BEMNETADEFIS/Robo-Sheild-For-Arduino-ROB-11002/Others/Arduino_Robo_Shield_BOM.xlsx

Id | Designator | Package | Quantity | Designation | Supplier and ref | Price
1 | SW1 | switch-misc-9077-2 | 1 | SPST
2 | U1 | SparkFun-AUDIO-JACK | 1 | 3.5MM_JACK
3 | P12,P8 | SIL-8 | 2 | CONN_8
4 | P9 | SIL-6 | 1 | CONN_6
5 | Sensors1 | SIL-5 | 1 | CONN_5
6 | P13 | SIL-4 | 1 | BT/ZIGBEE
7 | P10 | SIL-4 | 1 | CONN_4
8 | P1 | SIL-2 | 1 | AUDIO_IN
9 | P11 | SIL-10 | 1 | CONN_10
10 | R11,R10,R12 | R4 | 3 | 470r
11 | R9 | R4 | 1 | 150k
12 | R1,R4,R3,R2 | R4 | 4 | 56K
13 | R7 | R4 | 1 | 68K
14 | R6 | R4 | 1 | 47K
15 | R5 | R4 | 1 | 330K
16 | R8 | R4 | 1 | 100K
17 | D10,D9,D7,D5,D14,D6,D11,D13,D12,D8 | LED-3MM | 10 | LED
18 | X1 | HC-49V | 1 | 3.5795MHz
19 | IC1 | DIP-18__300_ELL | 1 | MT8870P
20 | U3 | DIP-16__300_ELL | 1 | L293D_XL
21 | D2,D1 | D3 | 2 | 5.6V
22 | D4 | D3 | 1 | 1N14148
23 | C2,C1 | C1V5 | 2 | 10uF, 25V
24 | P14 | bornier2 | 1 | Motar1
25 | P15 | bornier2 | 1 | motar2
26 | P3 | bornier2 | 1 | MTR_PWR
27 | P7,P5 | 1pin | 2 | CONN_1
28 | SW2 | SparkFun-DIPSWITCH-02 | 1 | DPST
29 | R13,R14 | R4 | 2 | R
30 | P2 | bornier2 | 1 | BRD_PWR
