BEMNETADEFIS/Robo-Sheild-For-Arduino-ROB-11002/Hardware/Arduino_Robo_Shield.pdf

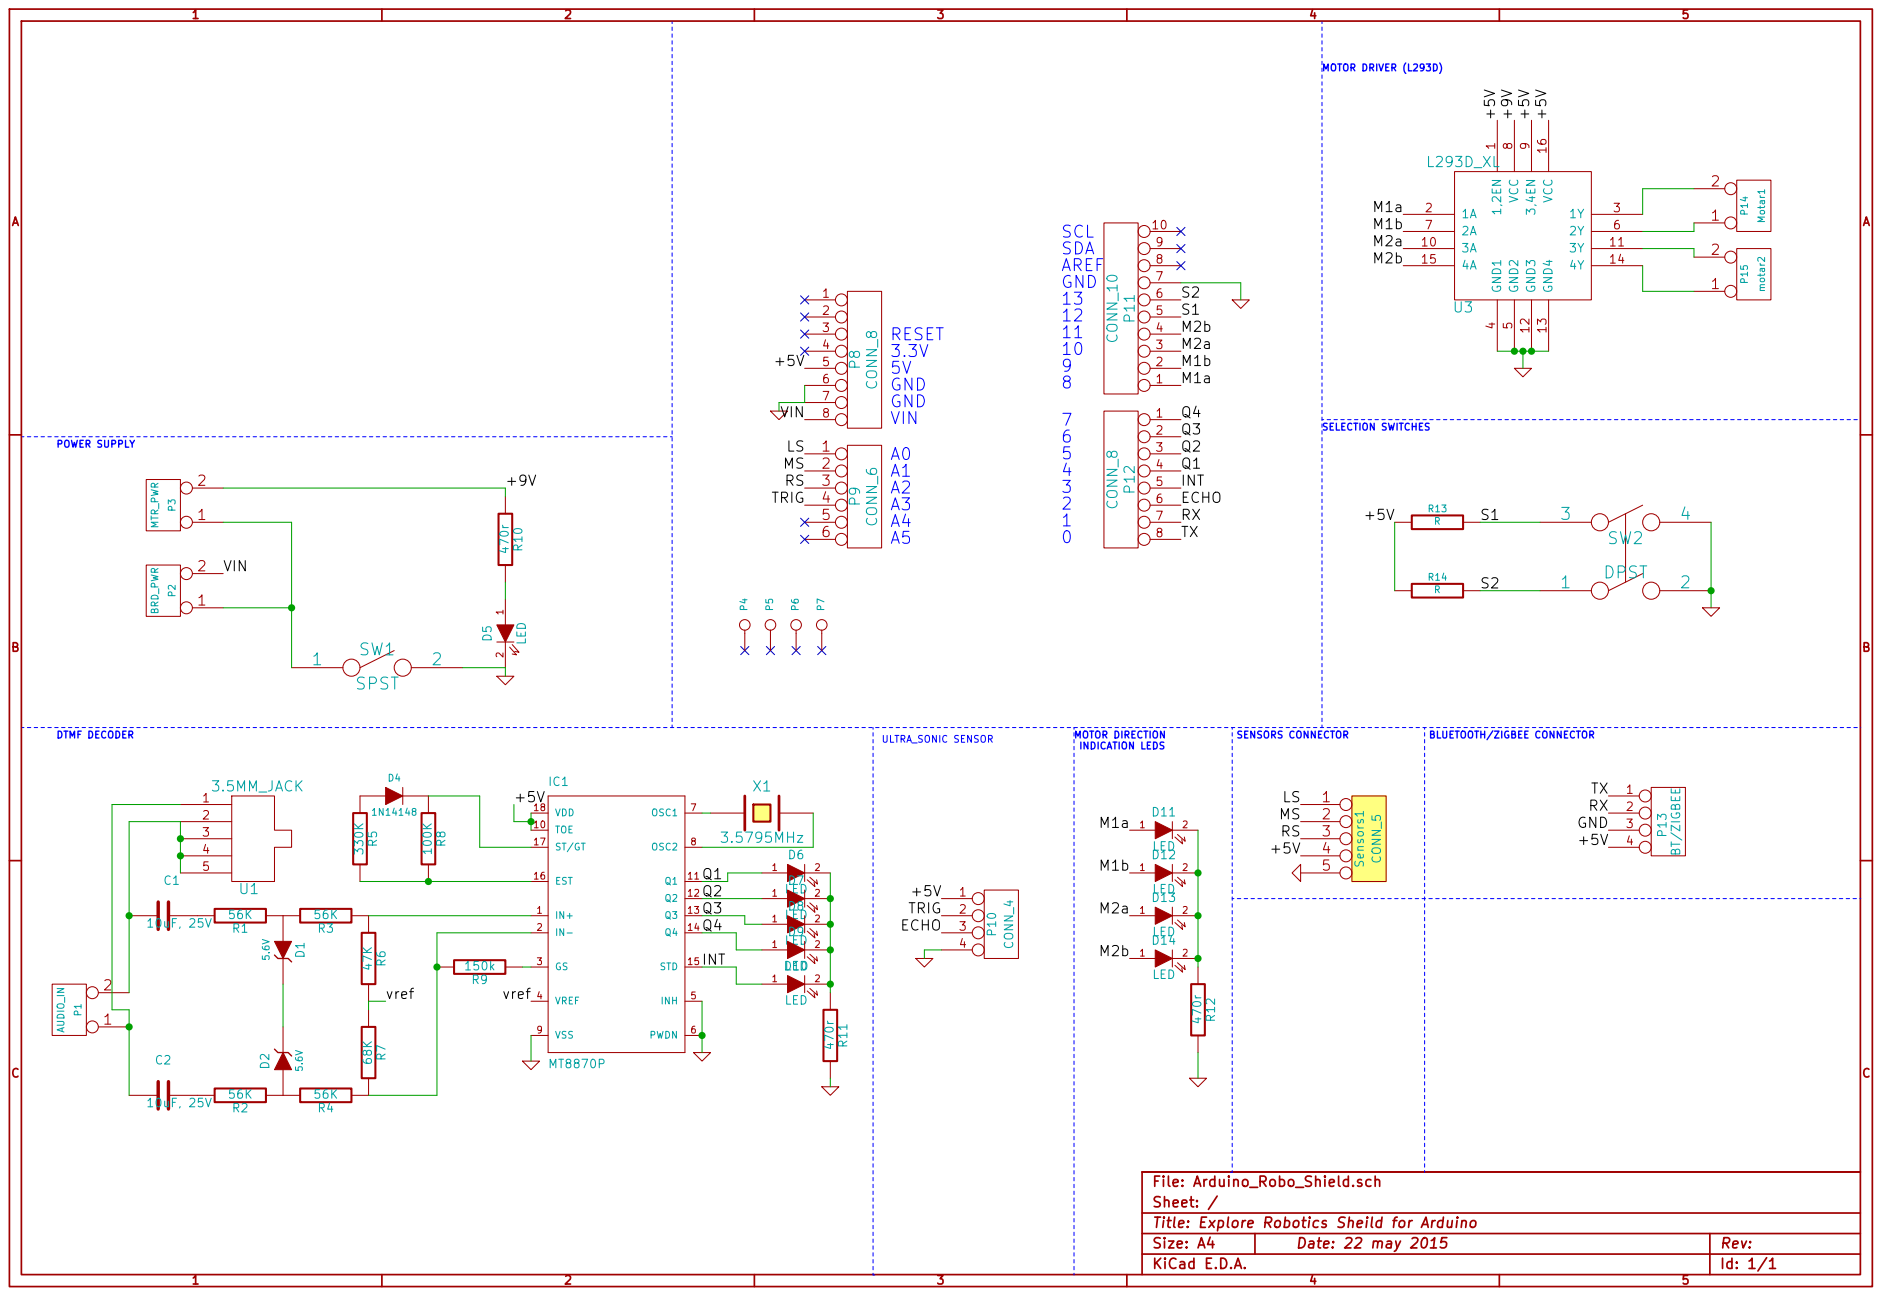
[picture p1: page 1]

Title: Explore Robotics Sheild for Arduino
KiCad E.D.A.
