BEMNETADEFIS/Robo-Sheild-For-Arduino-ROB-11002/Hardware/Arduino_Robo_Shield.kicad_pcb

## KiCad design Hardware/Arduino_Robo_Shield.kicad_pcb (2015-05-21)

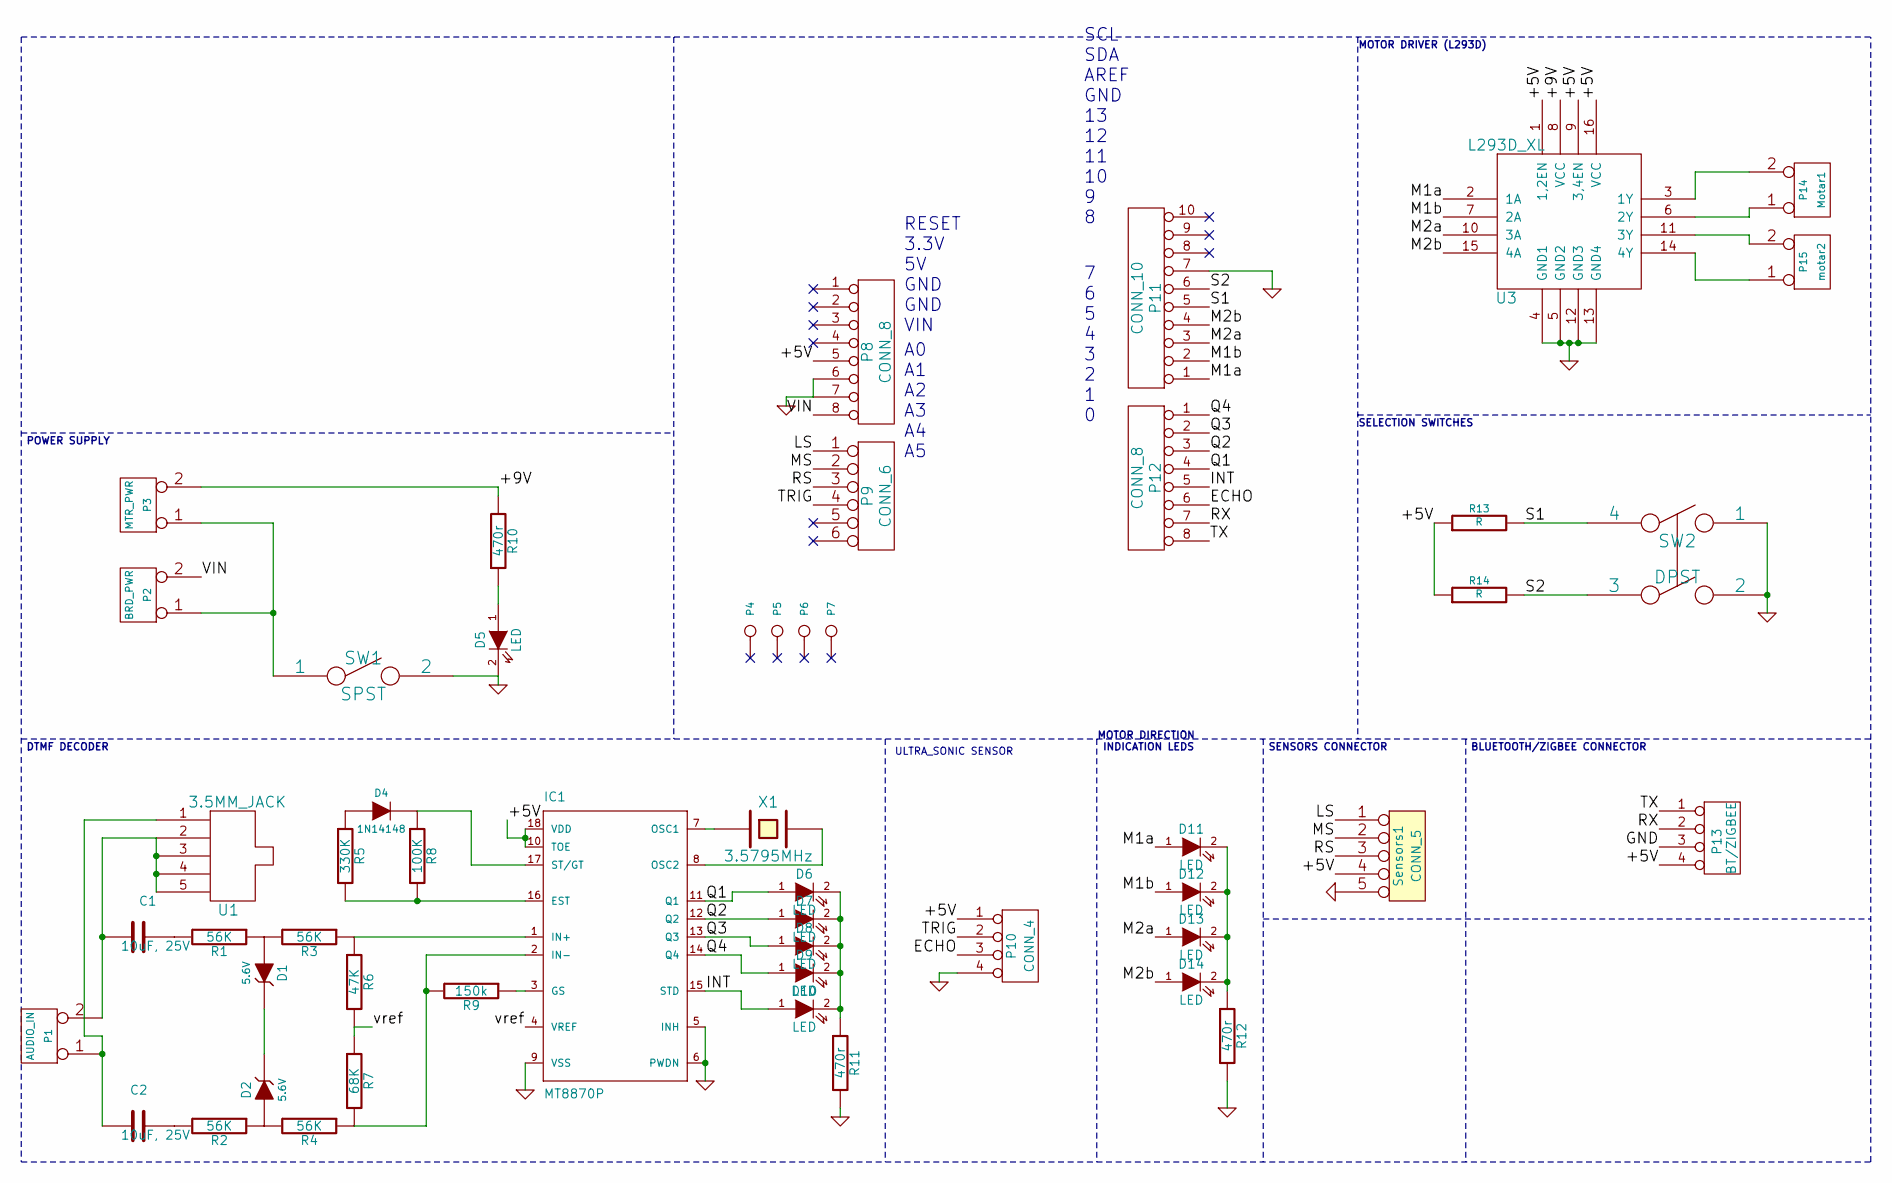
[picture p2: schematic Arduino_Robo_Shield.sch]

Parts:
C1, C2: 10uF, 25V
D1, D2: 5.6V
D4: 1N14148
D5, D6, D7, D8, D9, D10, D11, D12, D13, D14: LED
IC1: MT8870P; mitel-DIL18
P1: AUDIO_IN
P2: BRD_PWR
P3: MTR_PWR
P4, P5, P6, P7: CONN_1
P8, P12: CONN_8
P9: CONN_6
P10: CONN_4
P11: CONN_10
P13: BT/ZIGBEE
P14: Motar1
P15: motar2
R1, R2, R3, R4: 56K
R5: 330K
R6: 47K
R7: 68K
R8: 100K
R9: 150k
R10, R11, R12: 470r
R13, R14: R
SW1: SPST
SW2: DPST
Sensors1: CONN_5
U1: 3.5MM_JACK
U3: L293D_XL
X1: 3.5795MHz

Connections:
/+5V: IC1.10 (TOE), IC1.18 (VDD), P8.5, P10.1, P13.4, R13.1, R14.1, Sensors1.4, U3.1 (1,2EN), U3.9 (3,4EN), U3.16 (VCC)
/+9V: P3.2 (PM), R10.2, U3.8 (VCC)
/ECHO: P10.3, P12.6
/INT: D10.1 (A), IC1.15 (STD), P12.5
/LS: P9.1, Sensors1.1
/M1a: D11.1 (A), P11.1, U3.2 (1A)
/M1b: D12.1 (A), P11.2, U3.7 (2A)
/M2a: D13.1 (A), P11.3, U3.10 (3A)
/M2b: D14.1 (A), P11.4, U3.15 (4A)
/MS: P9.2, Sensors1.2
/Q1: D6.1 (A), IC1.11 (Q1), P12.4
/Q2: D7.1 (A), IC1.12 (Q2), P12.3
/Q3: D8.1 (A), IC1.13 (Q3), P12.2
/Q4: D9.1 (A), IC1.14 (Q4), P12.1
/RS: P9.3, Sensors1.3
/RX: P12.7, P13.2
/S1: P11.5, R13.2, SW2.4
/S2: P11.6, R14.2, SW2.3
/TRIG: P9.4, P10.2
/TX: P12.8, P13.1
/VIN: P2.2 (PM), P8.8
/vref: IC1.4 (VREF), R6.2, R7.1
GND: D5.2 (K), IC1.5 (INH), IC1.6 (PWDN), IC1.9 (VSS), P8.6, P8.7, P10.4, P11.7, P13.3, R11.2, R12.2, SW1.2, SW2.1, SW2.2, Sensors1.5, U3.4 (GND1), U3.5 (GND2), U3.12 (GND3), U3.13 (GND4)
unnamed: IC1.3 (GS), R9.1
unnamed: D1.2 (K), D2.2 (K)
unnamed: IC1.1 (IN+), R3.1, R6.1
unnamed: D4.2 (K), IC1.17 (ST/GT), R8.1
unnamed: IC1.7 (OSC1), X1.1
unnamed: IC1.8 (OSC2), X1.2
unnamed: P2.1, P3.1, SW1.1
unnamed: D5.1 (A), R10.1
unnamed: P15.1, U3.14 (4Y)
unnamed: P14.2 (PM), U3.3 (1Y)
unnamed: P15.2 (PM), U3.11 (3Y)
unnamed: P14.1, U3.6 (2Y)
unnamed: D2.1 (A), R2.1, R4.2
unnamed: D1.1 (A), R1.1, R3.2
unnamed: C2.2, P1.1, U1.1
unnamed: C2.1, R2.2
unnamed: C1.2, P1.2 (PM), U1.2, U1.3, U1.4, U1.5
unnamed: C1.1, R1.2
unnamed: D4.1 (A), R5.1
unnamed: IC1.16 (EST), R5.2, R8.2
unnamed: D6.2 (K), D7.2 (K), D8.2 (K), D9.2 (K), D10.2 (K), R11.1
unnamed: IC1.2 (IN-), R4.1, R7.2, R9.2
unnamed: D11.2 (K), D12.2 (K), D13.2 (K), D14.2 (K), R12.1

Notes on the sheet:
MOTOR DRIVER (L293D)
POWER SUPPLY
DTMF DECODER
MOTOR DIRECTION INDICATION LEDS
SENSORS CONNECTOR
BLUETOOTH/ZIGBEE CONNECTOR
SELECTION SWITCHES
7 6 5 4 3 2 1 0
SCL SDA AREF GND 13 12 11 10 9 8
A0 A1 A2 A3 A4 A5
RESET 3.3V 5V GND GND VIN
ULTRA_SONIC SENSOR

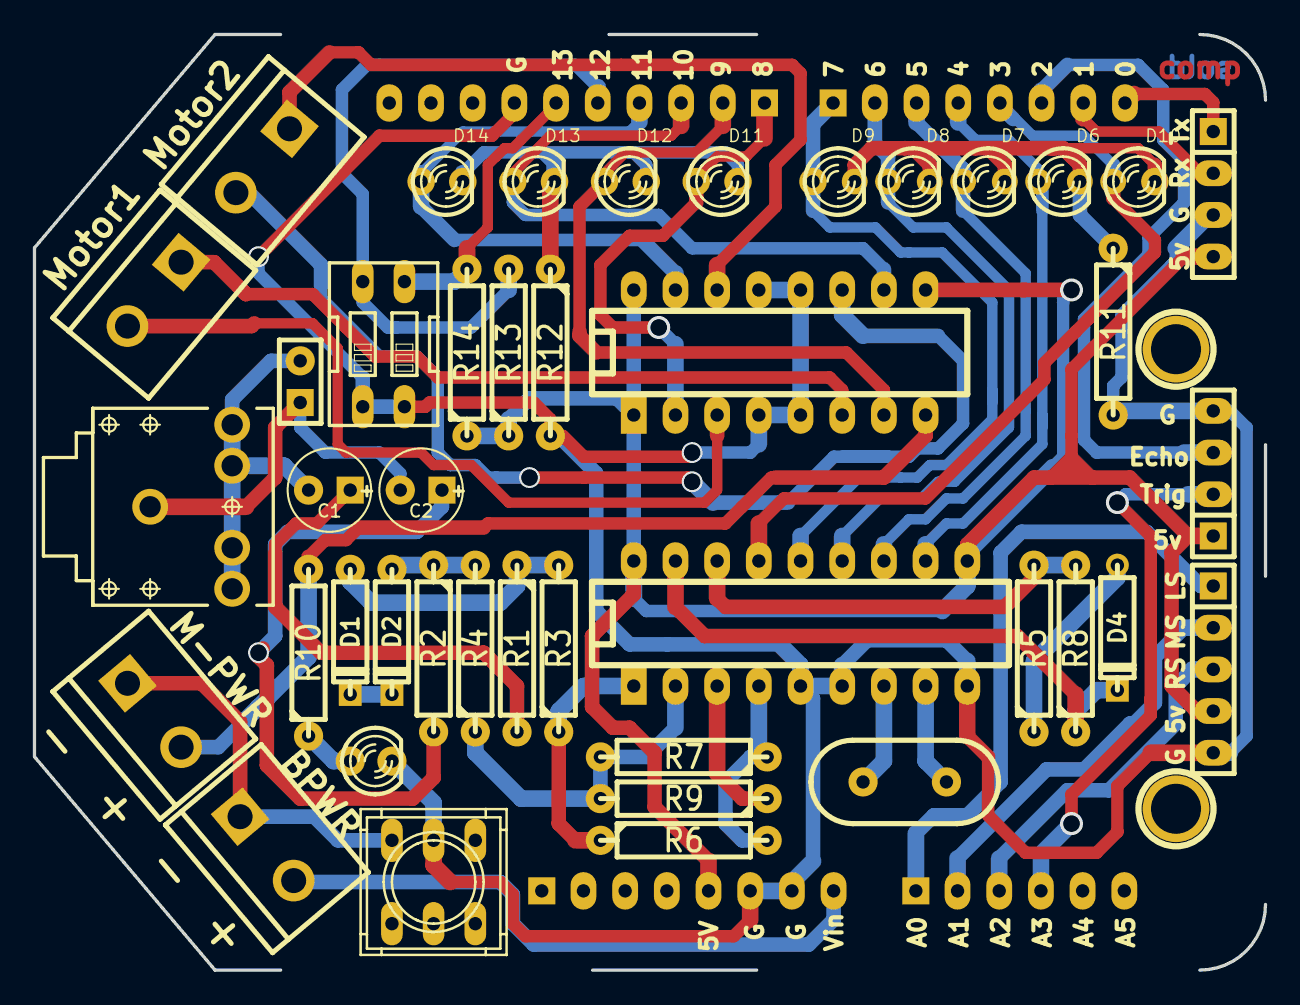
[picture p3: board Arduino_Robo_Shield.kicad_pcb from above]

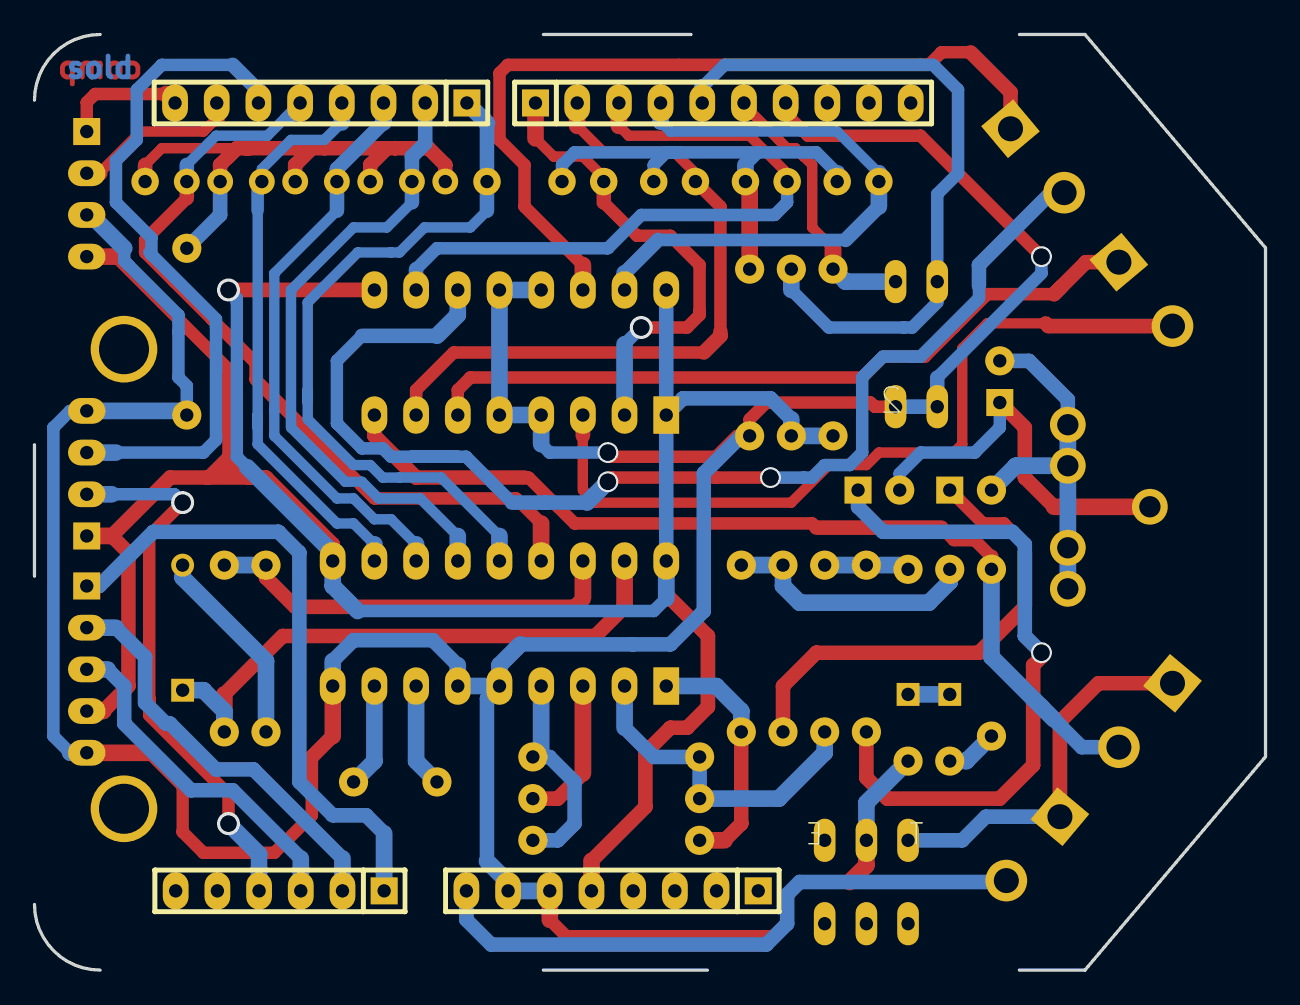
[picture p4: board Arduino_Robo_Shield.kicad_pcb from below]

Board: 2 copper layers, 75.0 x 57.0 mm, 49 parts (4 on the bottom side), 46 nets.
