BEMNETADEFIS/Robo-Sheild-For-Arduino-ROB-11002/(commit log)

2015-05-21 Added design Files
    [Arduino_Robo_Shield-append.kicad_pcb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]
2015-05-21 added folder structure
    [Arduino_Robo_Shield_BOM.xlsx, Specification.xlsx]
2015-05-22 Beautified Schematic
    Changed the layout style of schematic, generated pdf with the plot
    option
    [Arduino_Robo_Shield.sch]
2015-05-29 Obstacle Avoidance
    Added code for Obstacle Avoidance robot
    [Cellphone_Controlled.ino, Computer_Controlled.ino, Light_Follower.ino, Obstacle_Avoidance.ino]
